dansVibin/mipStabilization/Solidworks/3D_model.PNG

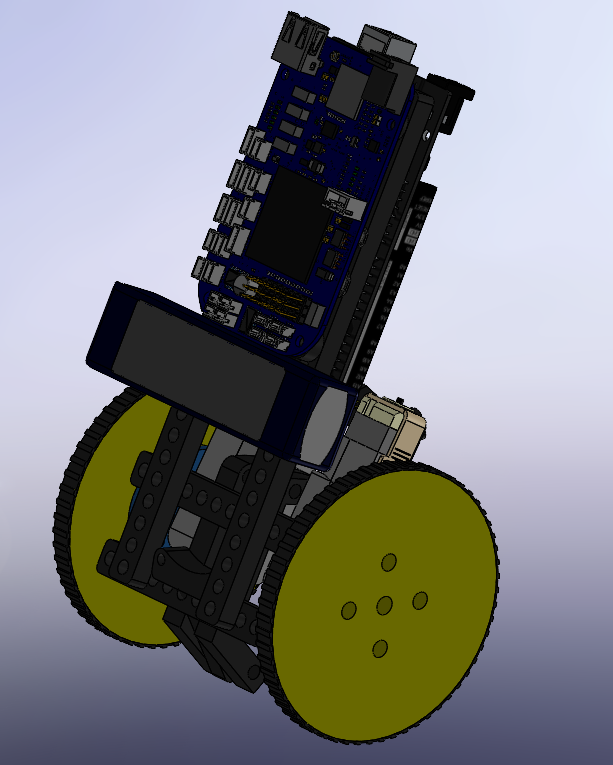
Solidworks/3D_model.PNG
