dansVibin/mipStabilization/Solidworks/battery/LiPo Turnigy 1.6Ah_4.jpg

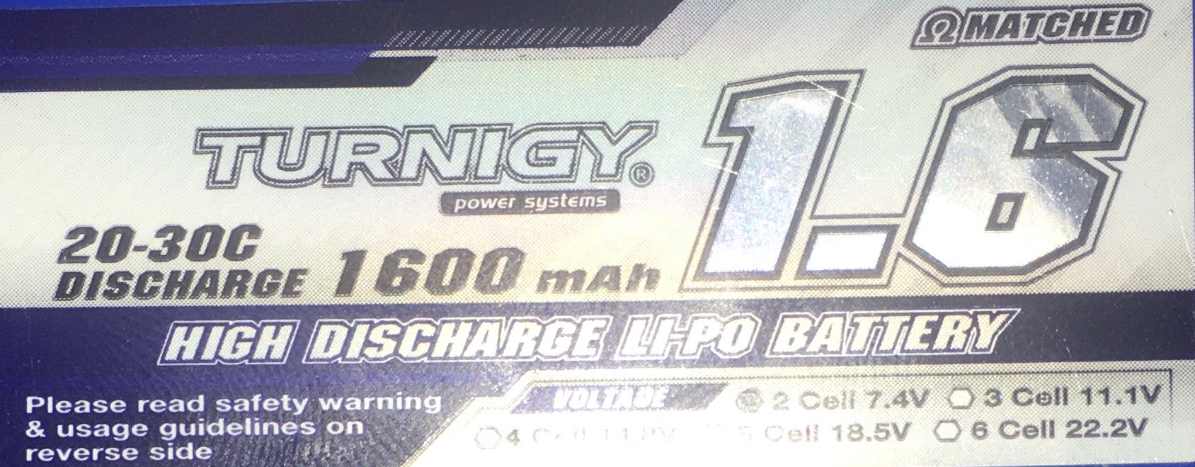
Solidworks/battery/LiPo Turnigy 1.6Ah_4.jpg
