dansVibin/mipStabilization/Solidworks/arduinoTextures/textBack.png

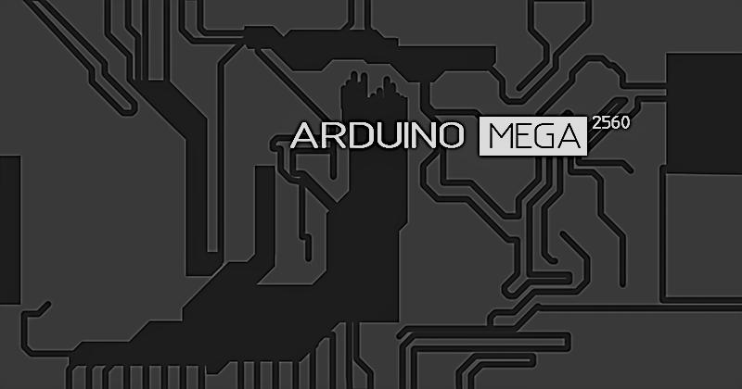
Solidworks/arduinoTextures/textBack.png
