dansVibin/mipStabilization/Solidworks/arduinoTextures/textFront.png

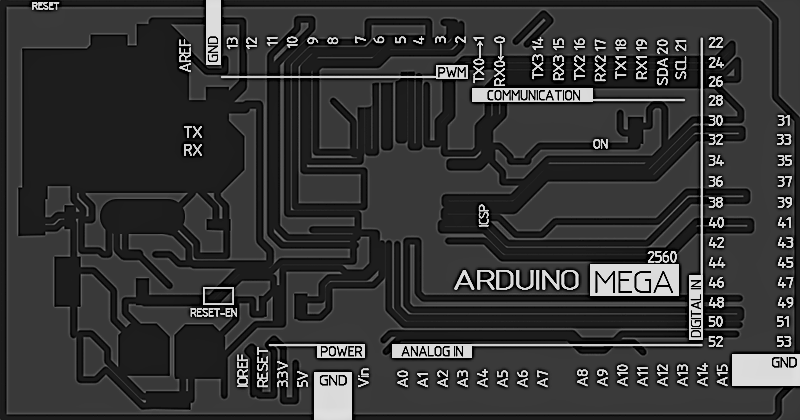
Solidworks/arduinoTextures/textFront.png
