dansVibin/mipStabilization/Solidworks/wheelAssem.SLDASM

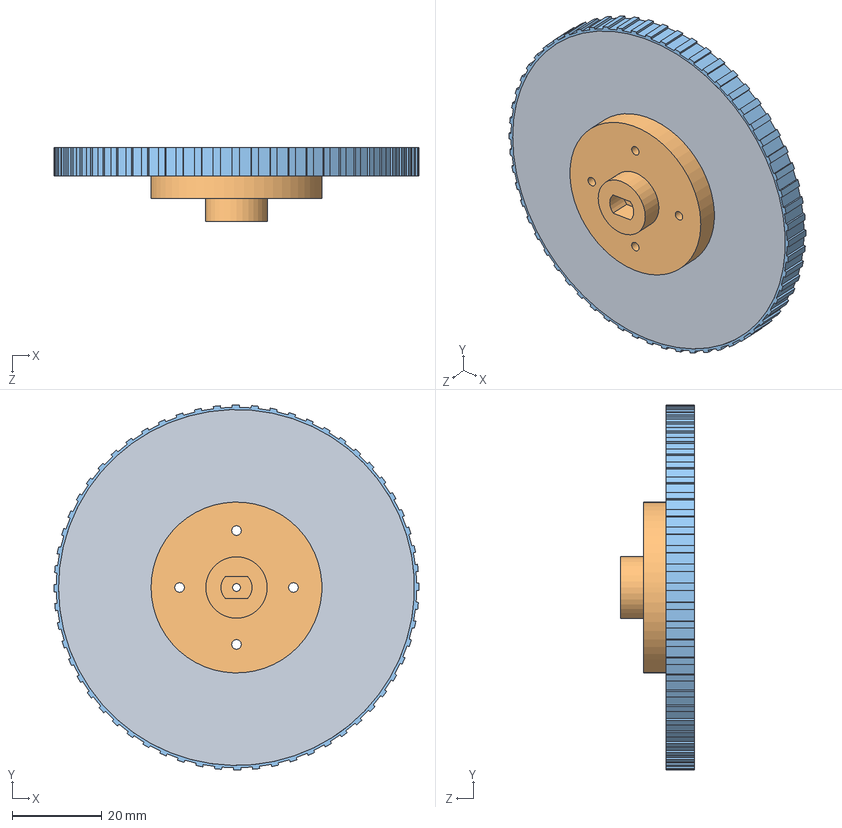
[picture p13: CAD file, 2021-05-07]
Solidworks/wheelAssem.SLDASM
81.4 x 81.4 x 16.5 mm
wheel
wheelHub
wheelTread
