dansVibin/mipStabilization/Solidworks/driveTrain.SLDASM

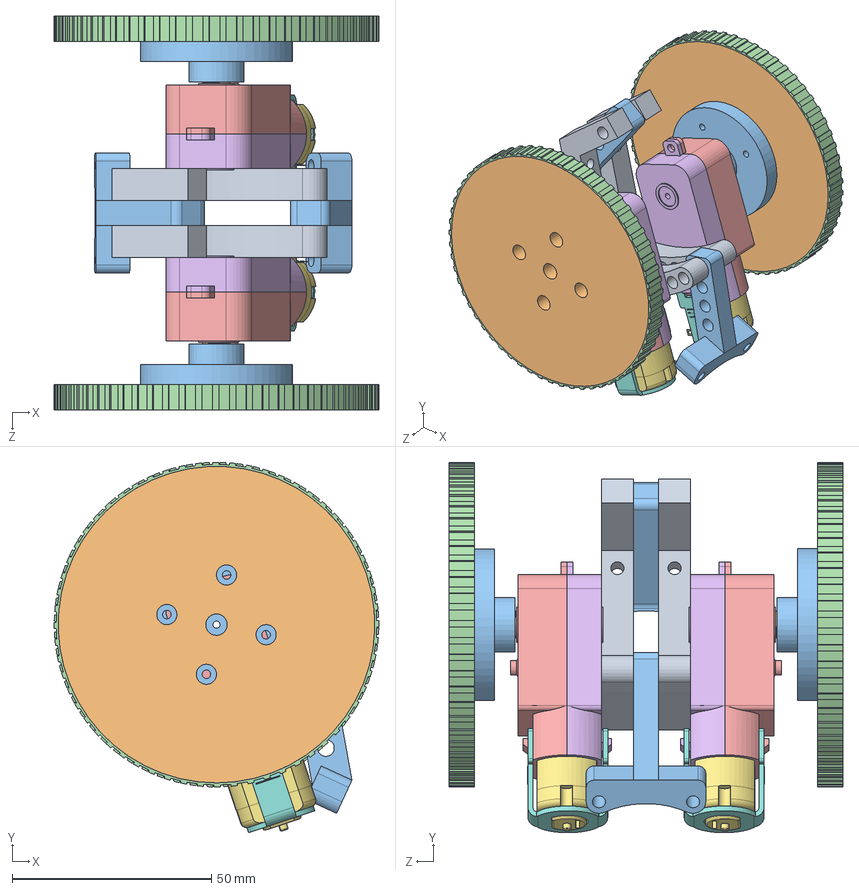
[picture p14: CAD file, 2021-05-07]
Solidworks/driveTrain.SLDASM
81.4 x 92.9 x 98.8 mm
motorBracket x 2
wheel x 2
wheelHub x 2
wheelTread x 2
GM9-driver_side x 2
GM9-encoder_side x 2
RM3-regular motor x 2
GMstrap2 x 2
screw_head1 x 4
output shaft x 2
spacerBlock x 2
