dansVibin/mipStabilization/Solidworks/battery/Battery.SLDASM

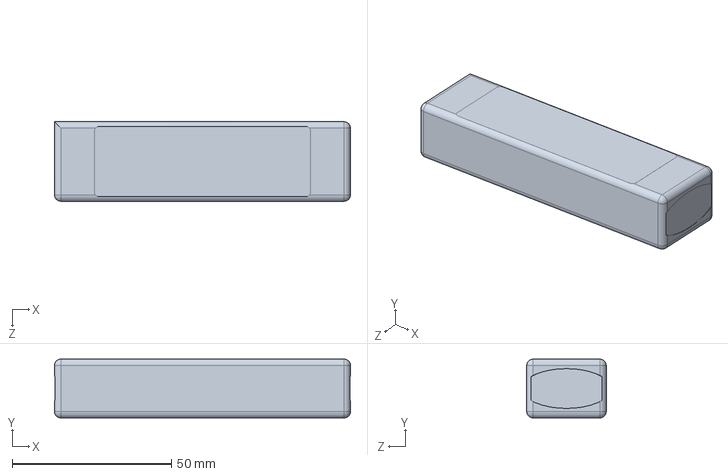
[picture p15: CAD file, 2021-05-07]
Solidworks/battery/Battery.SLDASM
93.0 x 18.5 x 25.0 mm
