dansVibin/mipStabilization/Solidworks/frame.SLDASM

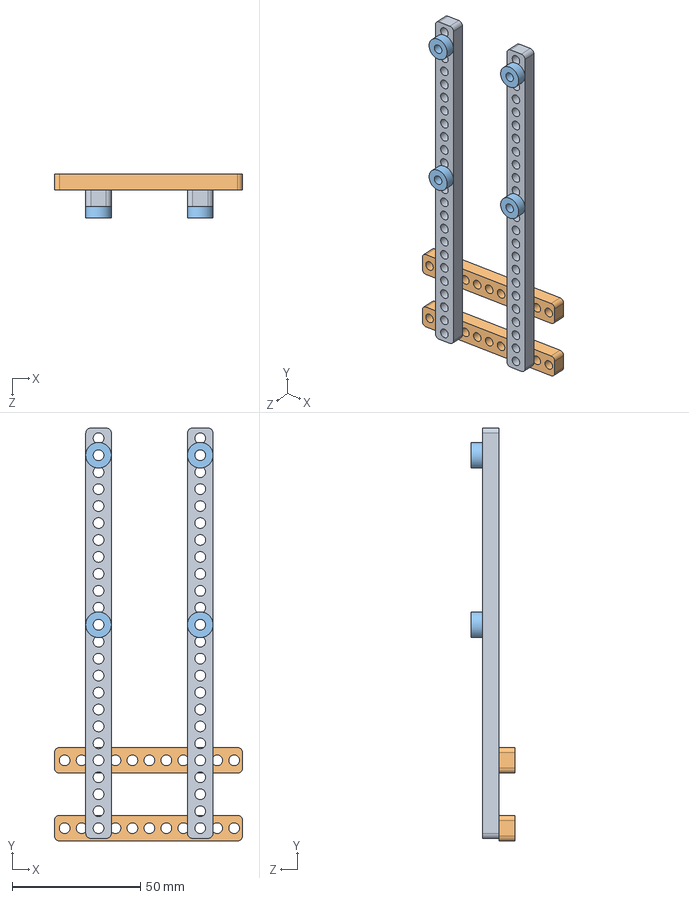
[picture p16: CAD file, 2021-05-07]
Solidworks/frame.SLDASM
73.4 x 161.0 x 17.2 mm
strutLong x 2
strutShort x 2
spacer x 4
