dansVibin/mipStabilization/Solidworks/GM9-export/Solarbotics_GM9-Assem.SLDASM

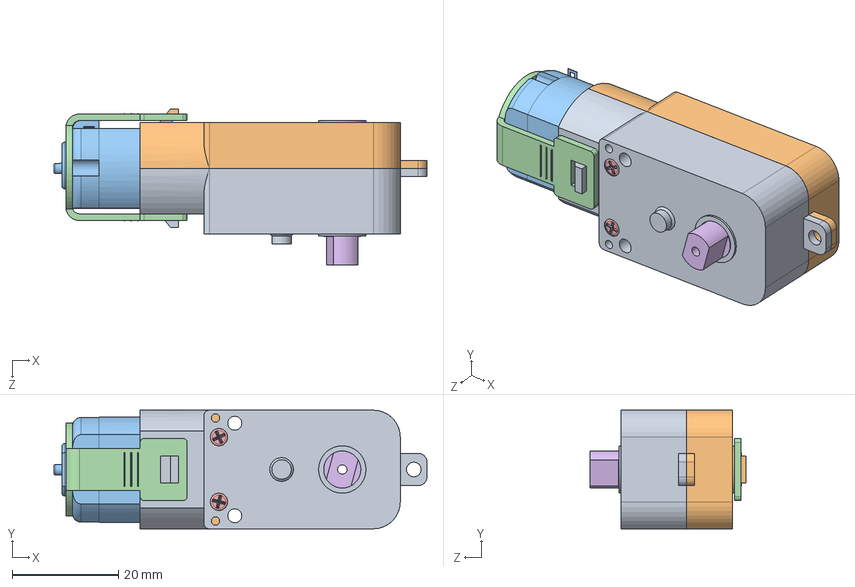
[picture p17: CAD file, 2021-05-07]
Solidworks/GM9-export/Solarbotics_GM9-Assem.SLDASM
70.2 x 22.4 x 29.3 mm
GM9-driver_side
GM9-encoder_side
RM3-regular motor
GMstrap2
screw_head1 x 2
output shaft
