dansVibin/mipStabilization/Solidworks/turnigyBattery.SLDASM

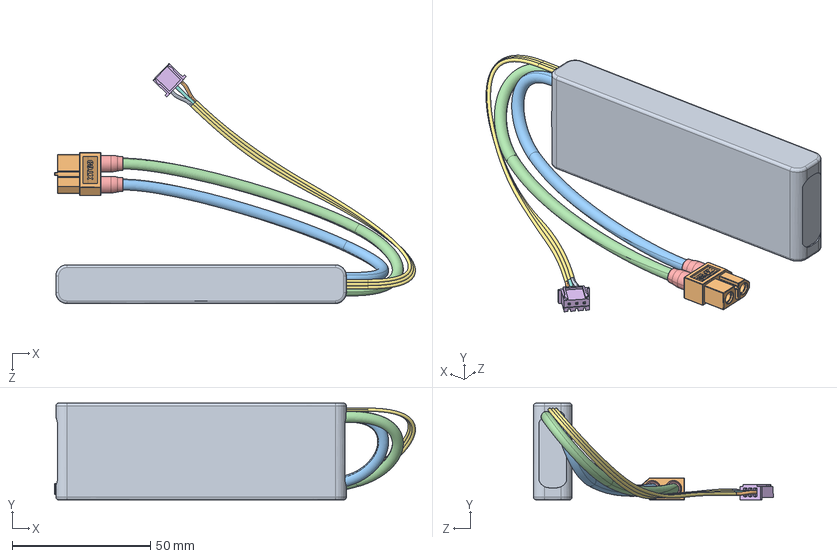
[picture p18: CAD file, 2021-05-07]
Solidworks/turnigyBattery.SLDASM
130.5 x 35.0 x 86.8 mm
SA_Turnigy_1800mAh_2S__nano_tech_Lipo_Battery.IGS
XT60 MALE.IGS
Cble^Cable_3-SA_TURNIGY NANOTECH 1800mAh 2S.IGS
Cble^Cable_4-SA_TURNIGY NANOTECH 1800mAh 2S.IGS
Pièce2^SA_TURNIGY NANOTECH 1800mAh 2S.IGS x 2
JST 2S.IGS
Pièce7^SA_TURNIGY NANOTECH 1800mAh 2S.IGS
Cble^Cable_6-SA_TURNIGY NANOTECH 1800mAh 2S.IGS
Cble^Cable_7-SA_TURNIGY NANOTECH 1800mAh 2S-001.IGS
Cble^Cable_9-SA_TURNIGY NANOTECH 1800mAh 2S.IGS
