dansVibin/mipStabilization/Solidworks/battery/CONNECTOR, MULTIPLEX, PLUG.SLDPRT

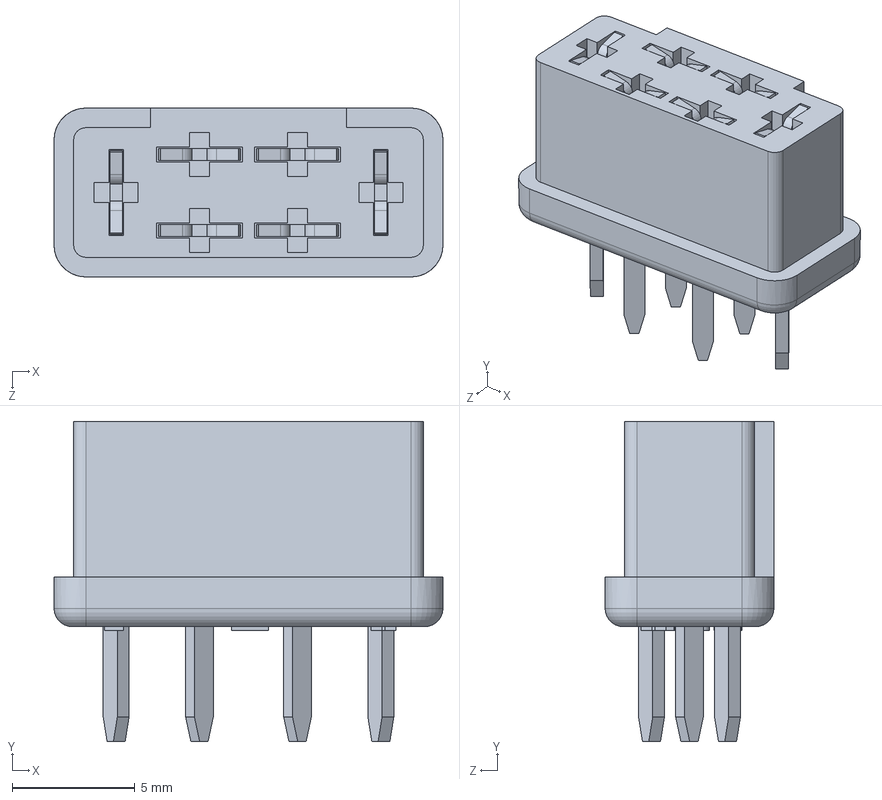
[picture p19: CAD file, 2021-05-07]
Solidworks/battery/CONNECTOR, MULTIPLEX, PLUG.SLDPRT
15.9 x 13.1 x 6.89 mm
