dansVibin/mipStabilization/Solidworks/GM9-export/GM9-driver_side.SLDPRT

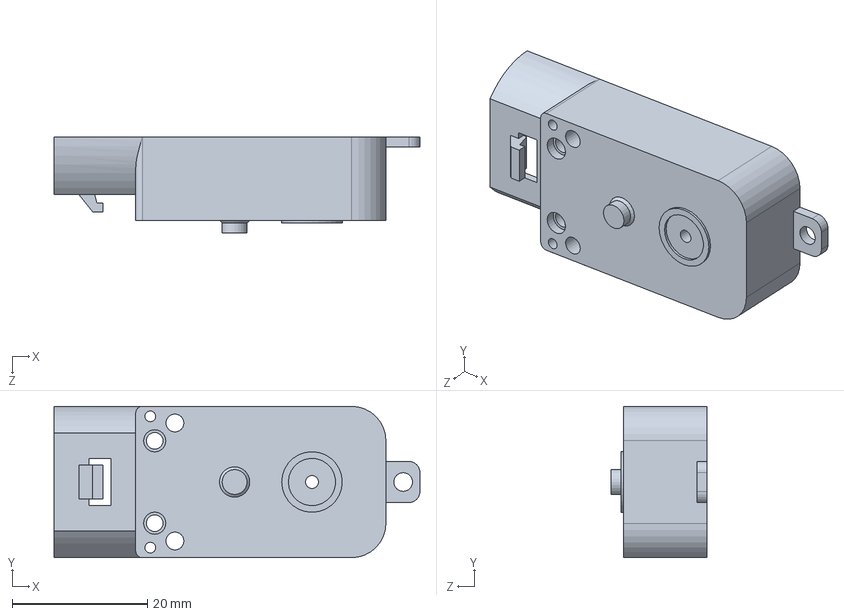
[picture p20: CAD file, 2021-05-07]
Solidworks/GM9-export/GM9-driver_side.SLDPRT
54.1 x 22.4 x 14.2 mm
