dansVibin/mipStabilization/Solidworks/battery/Connector JST XHP-4.SLDPRT

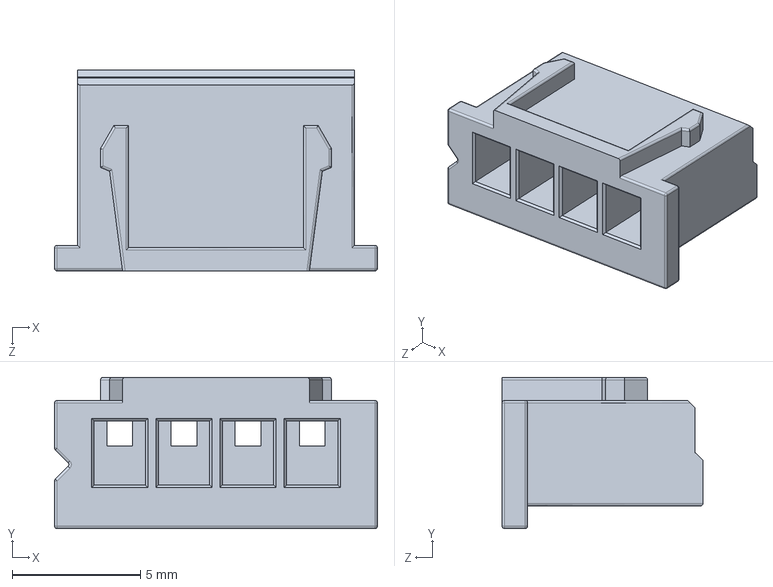
[picture p21: CAD file, 2021-05-07]
Solidworks/battery/Connector JST XHP-4.SLDPRT
12.6 x 5.90 x 7.84 mm
