dansVibin/mipStabilization/Solidworks/GM9-export/GMstrap2.SLDPRT

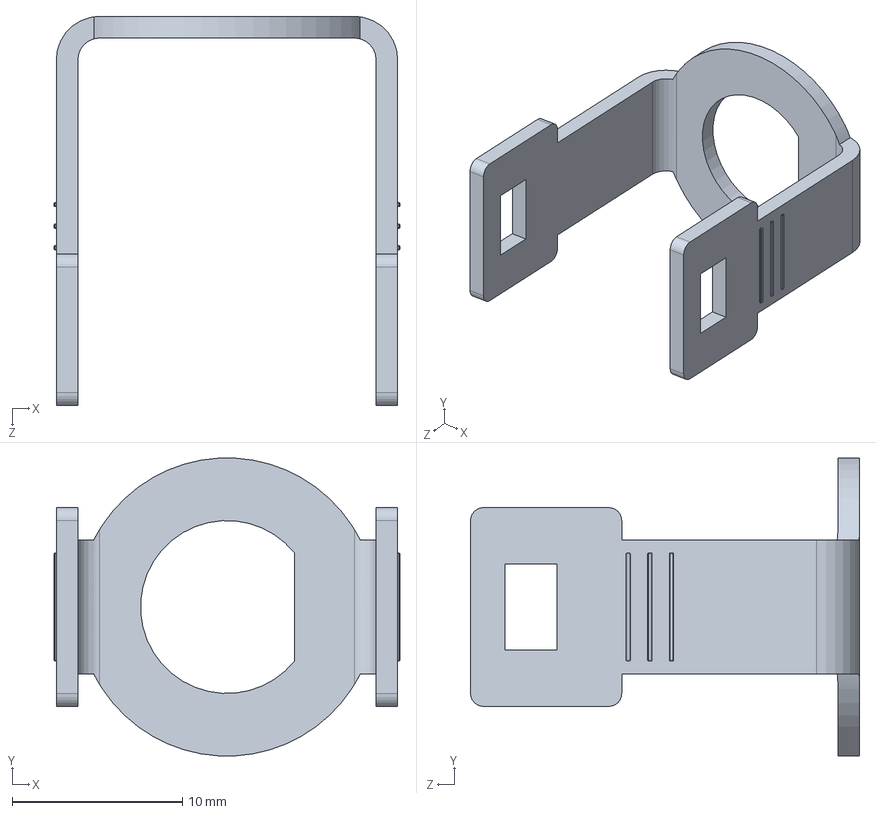
[picture p22: CAD file, 2021-05-07]
Solidworks/GM9-export/GMstrap2.SLDPRT
20.3 x 17.5 x 22.9 mm
