dansVibin/mipStabilization/Solidworks/motorBracket.SLDPRT

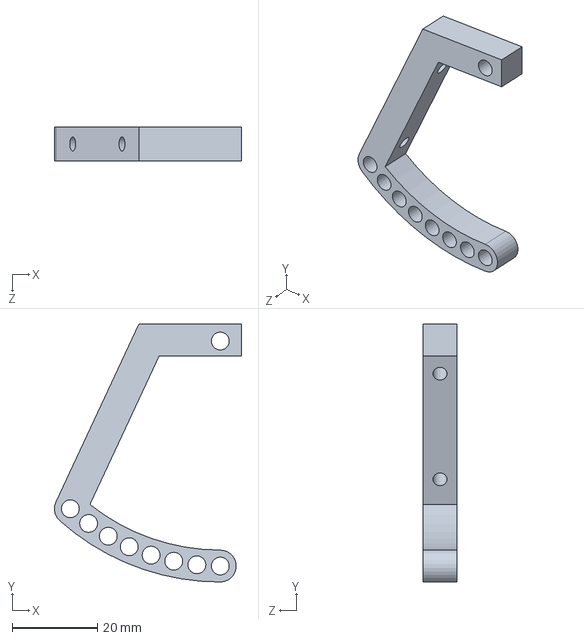
[picture p23: CAD file, 2021-05-07]
Solidworks/motorBracket.SLDPRT
44.0 x 60.6 x 8.00 mm
