dansVibin/mipStabilization/Solidworks/battery/Nanotech_1600mAh_3S_Lipo.SLDPRT

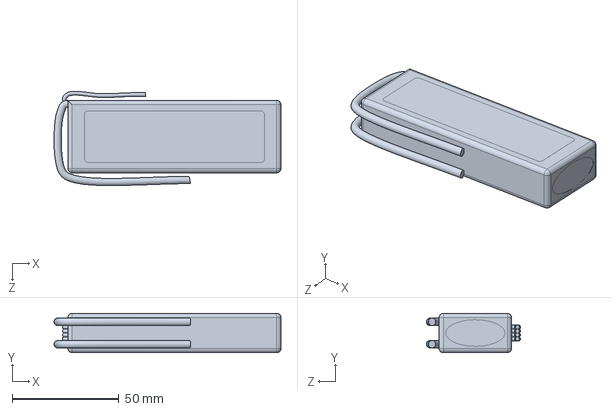
[picture p24: CAD file, 2021-05-07]
Solidworks/battery/Nanotech_1600mAh_3S_Lipo.SLDPRT
106.5 x 18.5 x 44.3 mm
