dansVibin/mipStabilization/Solidworks/GM9-export/RM3-regular motor.SLDPRT

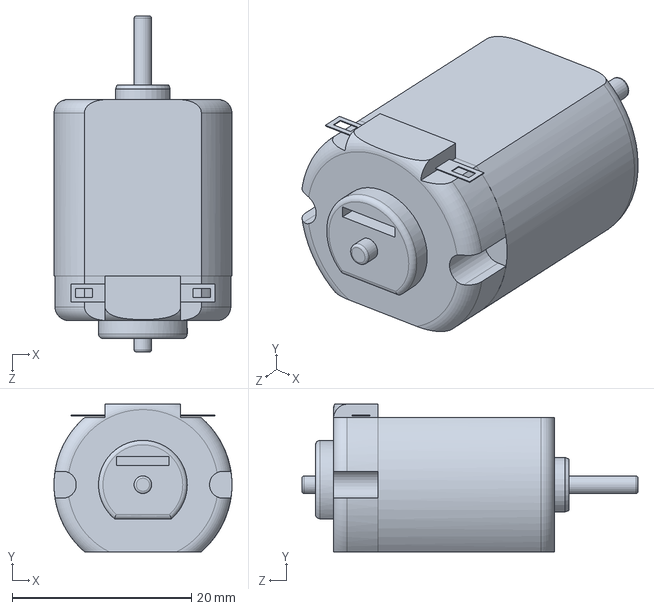
[picture p25: CAD file, 2021-05-07]
Solidworks/GM9-export/RM3-regular motor.SLDPRT
19.9 x 16.5 x 37.5 mm
