dansVibin/mipStabilization/Solidworks/strutLong.SLDPRT

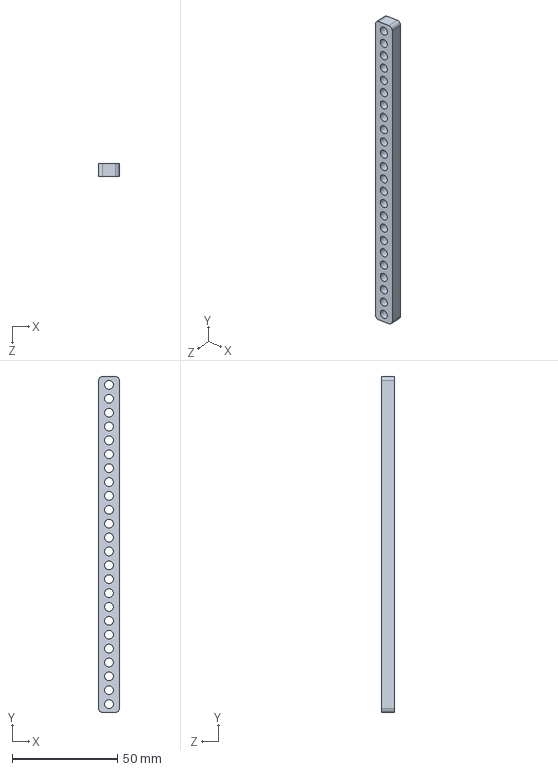
[picture p26: CAD file, 2021-05-07]
Solidworks/strutLong.SLDPRT
10.0 x 160.0 x 6.35 mm
