dansVibin/mipStabilization/Solidworks/GM9-export/output shaft.SLDPRT

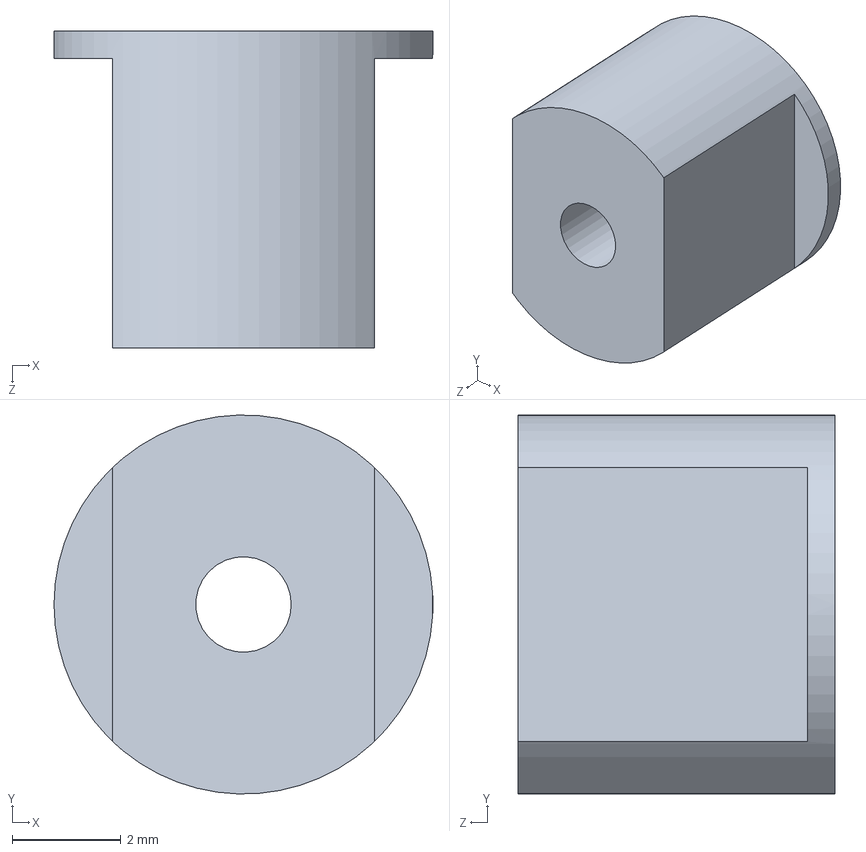
[picture p27: CAD file, 2021-05-07]
Solidworks/GM9-export/output shaft.SLDPRT
6.98 x 6.98 x 5.83 mm
