dansVibin/mipStabilization/Solidworks/spacerBlock.SLDPRT

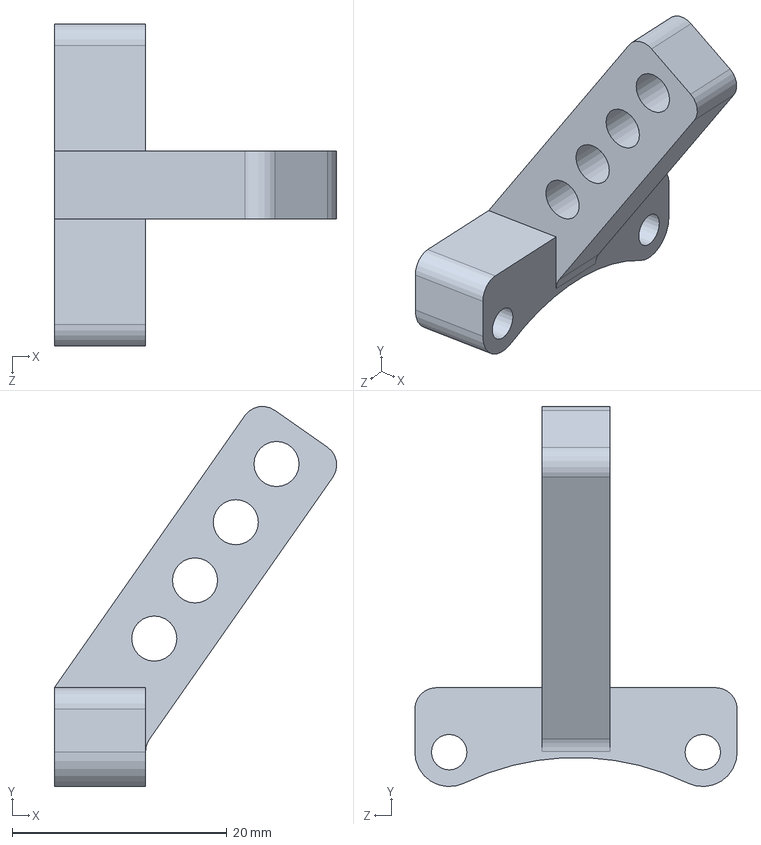
[picture p28: CAD file, 2021-05-07]
Solidworks/spacerBlock.SLDPRT
26.3 x 35.4 x 30.0 mm
