dansVibin/mipStabilization/Solidworks/GM9-export/GM9-encoder_side.SLDPRT

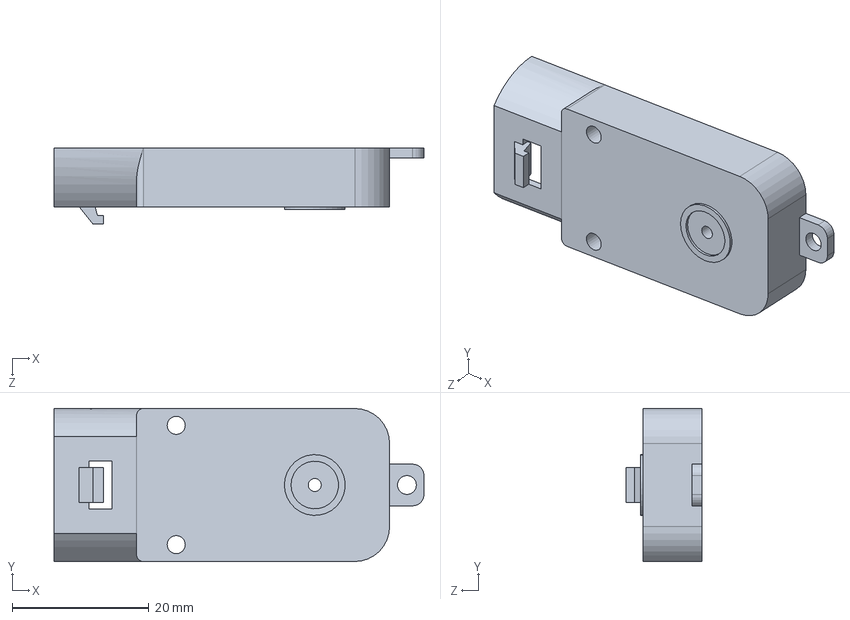
[picture p29: CAD file, 2021-05-07]
Solidworks/GM9-export/GM9-encoder_side.SLDPRT
54.1 x 22.4 x 11.2 mm
