dansVibin/mipStabilization/Solidworks/wheelHub.SLDPRT

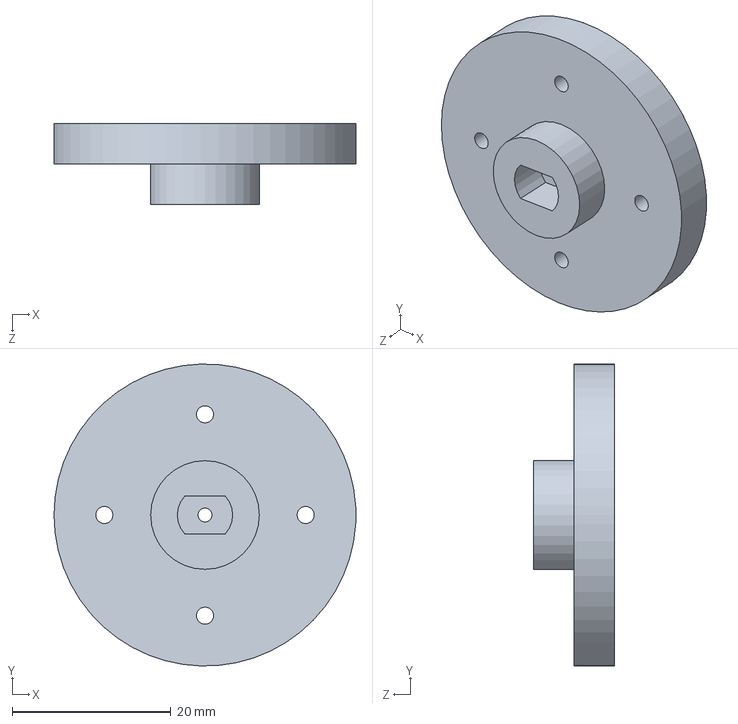
[picture p30: CAD file, 2021-05-07]
Solidworks/wheelHub.SLDPRT
38.1 x 38.1 x 10.2 mm
