dansVibin/mipStabilization/Solidworks/strutShort.SLDPRT

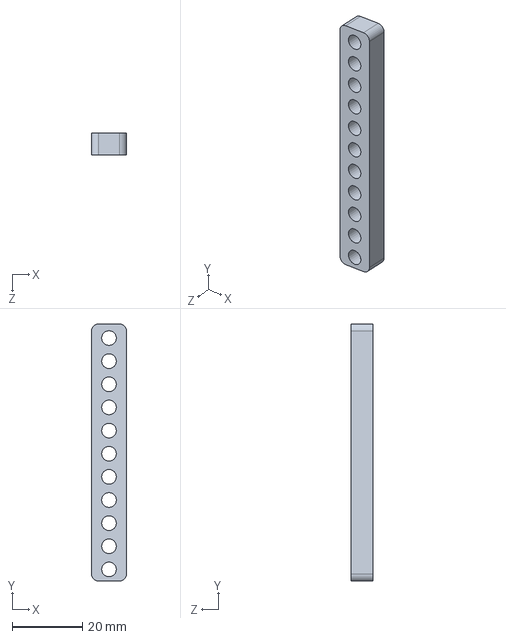
[picture p31: CAD file, 2021-05-07]
Solidworks/strutShort.SLDPRT
10.0 x 73.4 x 6.35 mm
