dansVibin/mipStabilization/Solidworks/wheel.SLDPRT

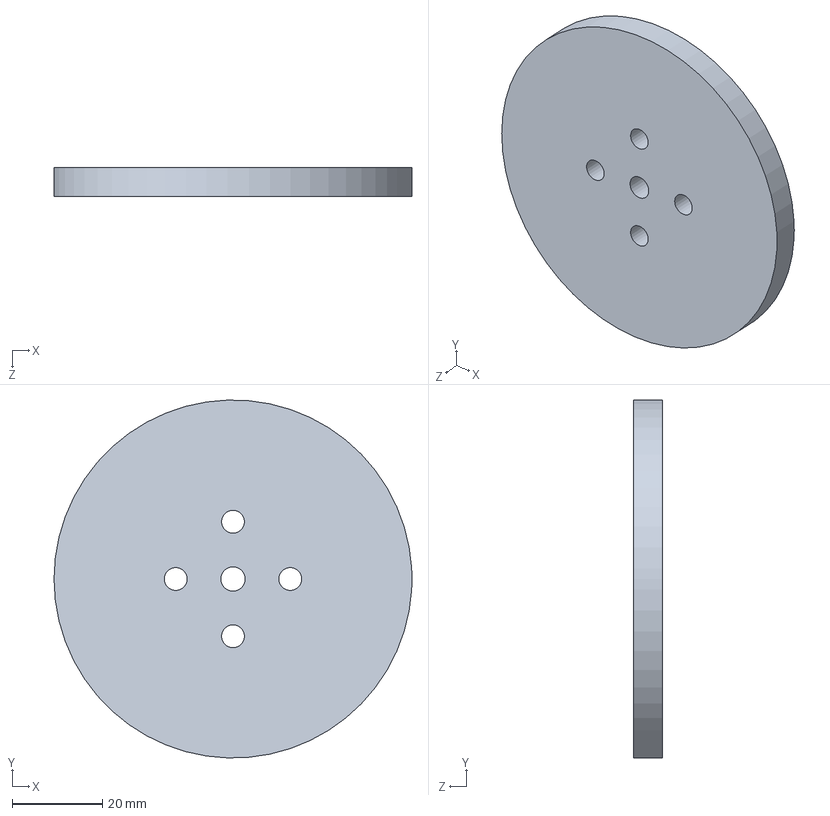
[picture p32: CAD file, 2021-05-07]
Solidworks/wheel.SLDPRT
79.4 x 79.3 x 6.35 mm
