dansVibin/mipStabilization/Solidworks/wheelTread.SLDPRT

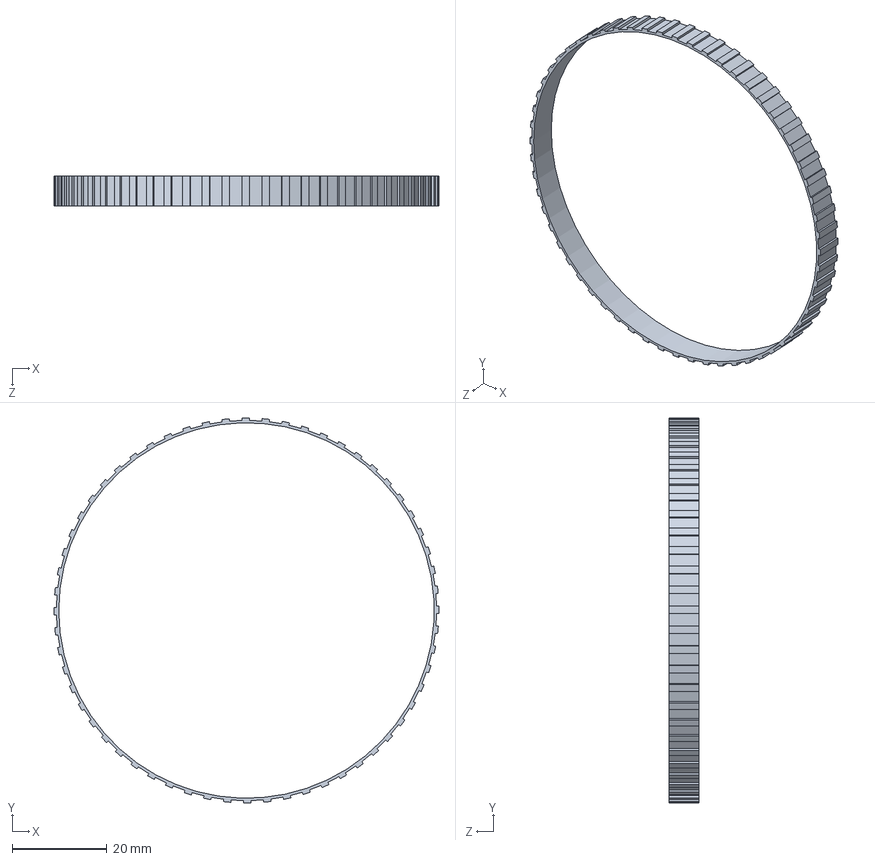
[picture p33: CAD file, 2021-05-07]
Solidworks/wheelTread.SLDPRT
81.4 x 81.4 x 6.35 mm
