dansVibin/mipStabilization/Solidworks/spacer.SLDPRT

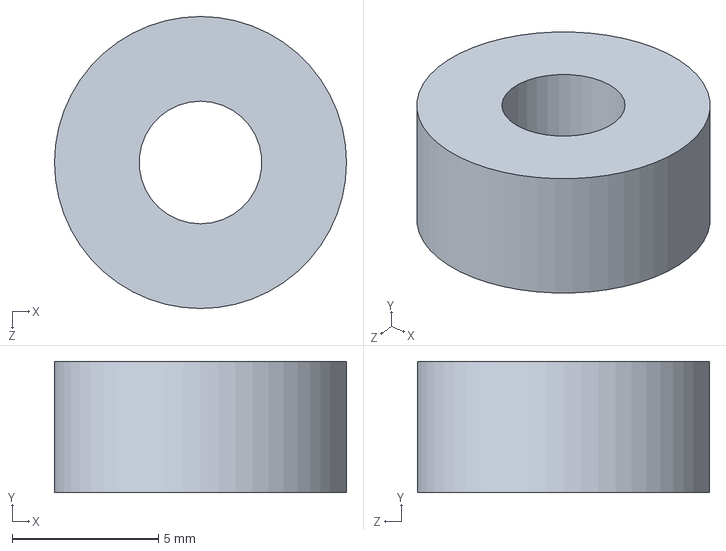
[picture p34: CAD file, 2021-05-07]
Solidworks/spacer.SLDPRT
10.0 x 4.50 x 10.0 mm
