dansVibin/mipStabilization/(list of files, cad)

Other CAD files:
Solidworks/GM9-export/screw_head1.SLDPRT
